jdice/DROP/Defense Thesis/img/v3_boardLayout.png

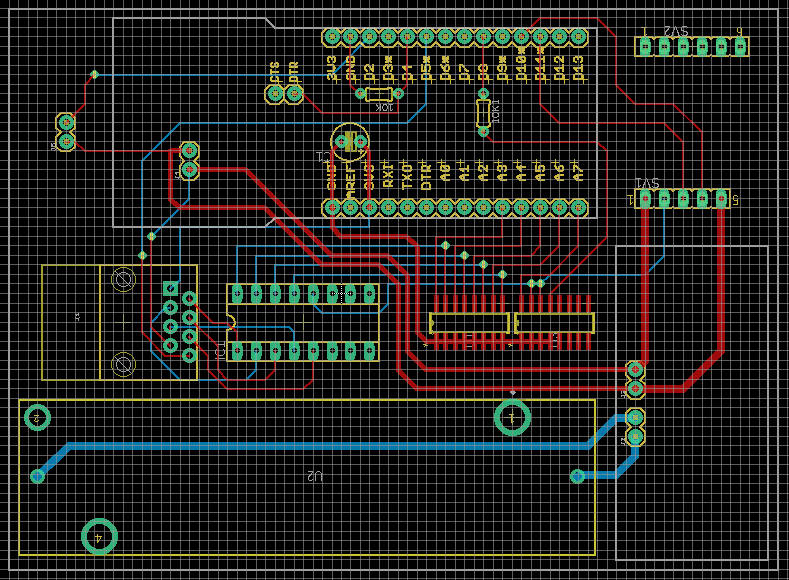
Defense Thesis/img/v3_boardLayout.png
