jdice/DROP/Defense Thesis/img/v3_boards.JPG

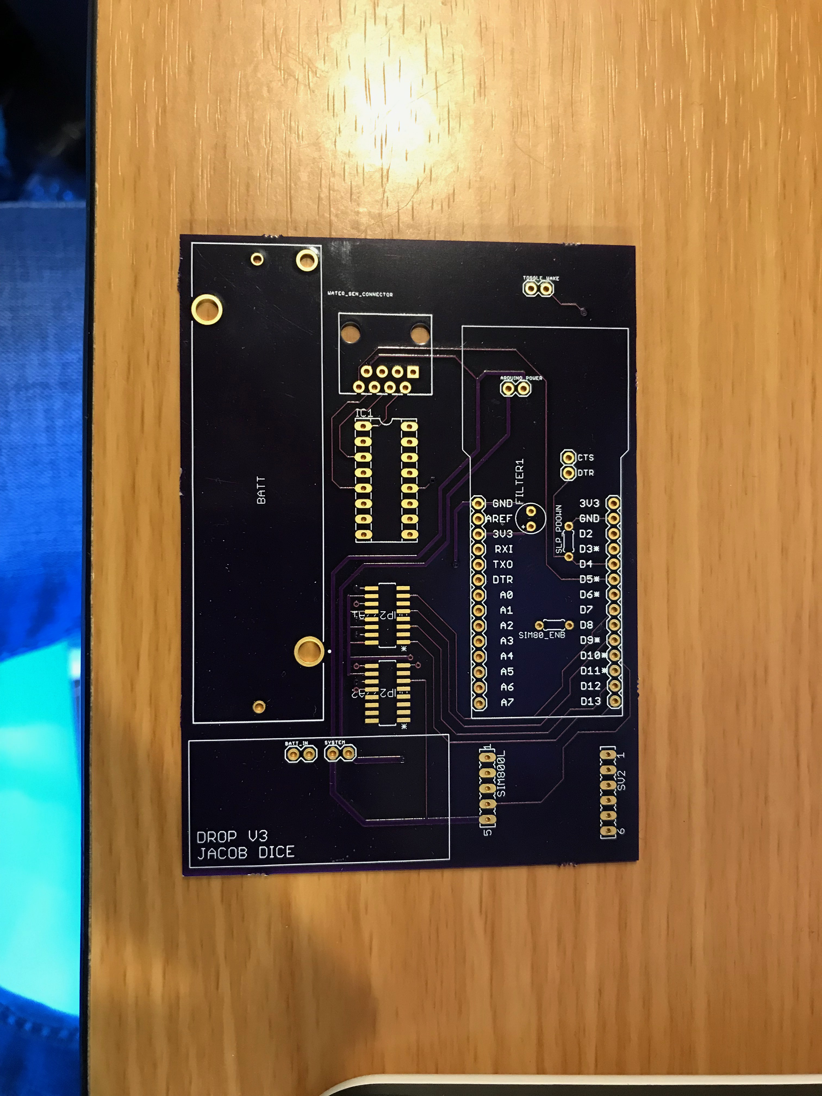
Defense Thesis/img/v3_boards.JPG
