jdice/DROP/Defense Thesis/img/v3_powerConsumption1.JPG

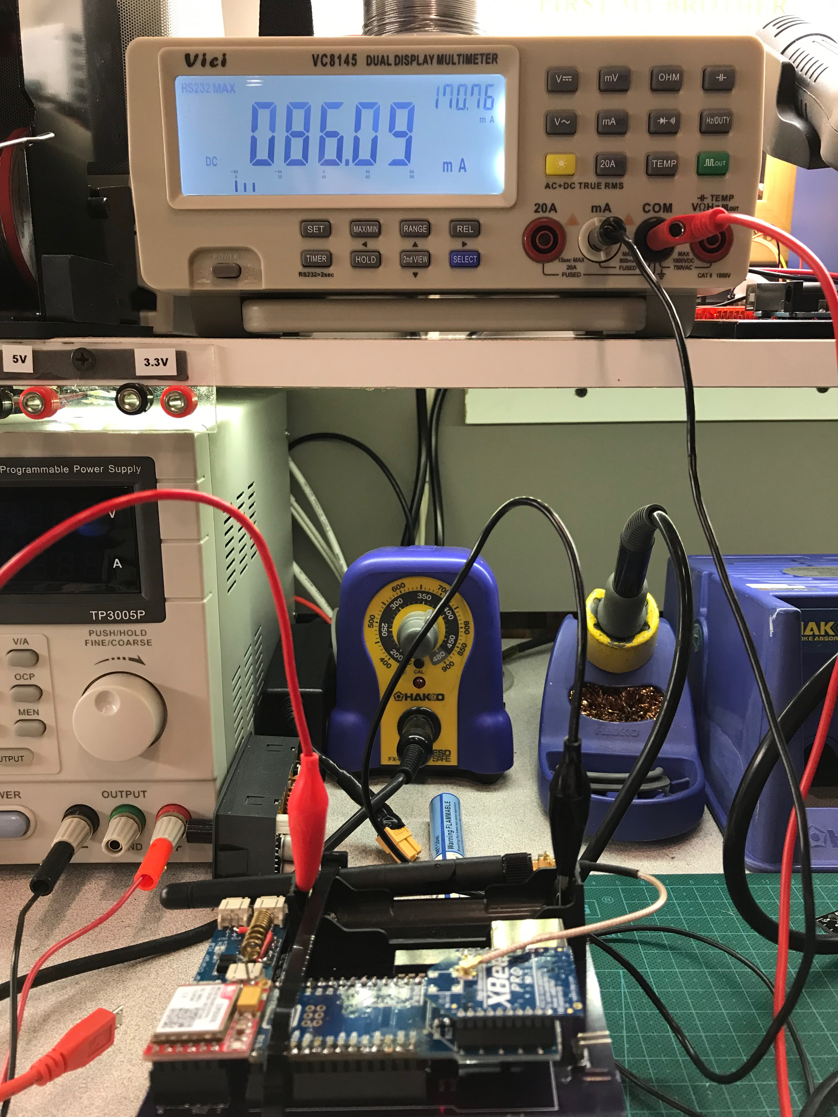
Defense Thesis/img/v3_powerConsumption1.JPG
