jdice/DROP/Defense Thesis/img/v3_powerConsumption2.JPG

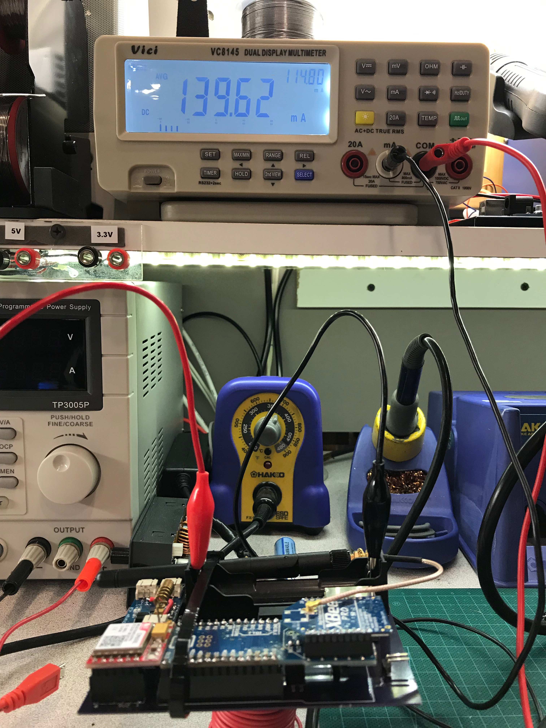
Defense Thesis/img/v3_powerConsumption2.JPG
