jdice/DROP/Defense Thesis/img/v3_powerConsumption3.JPG

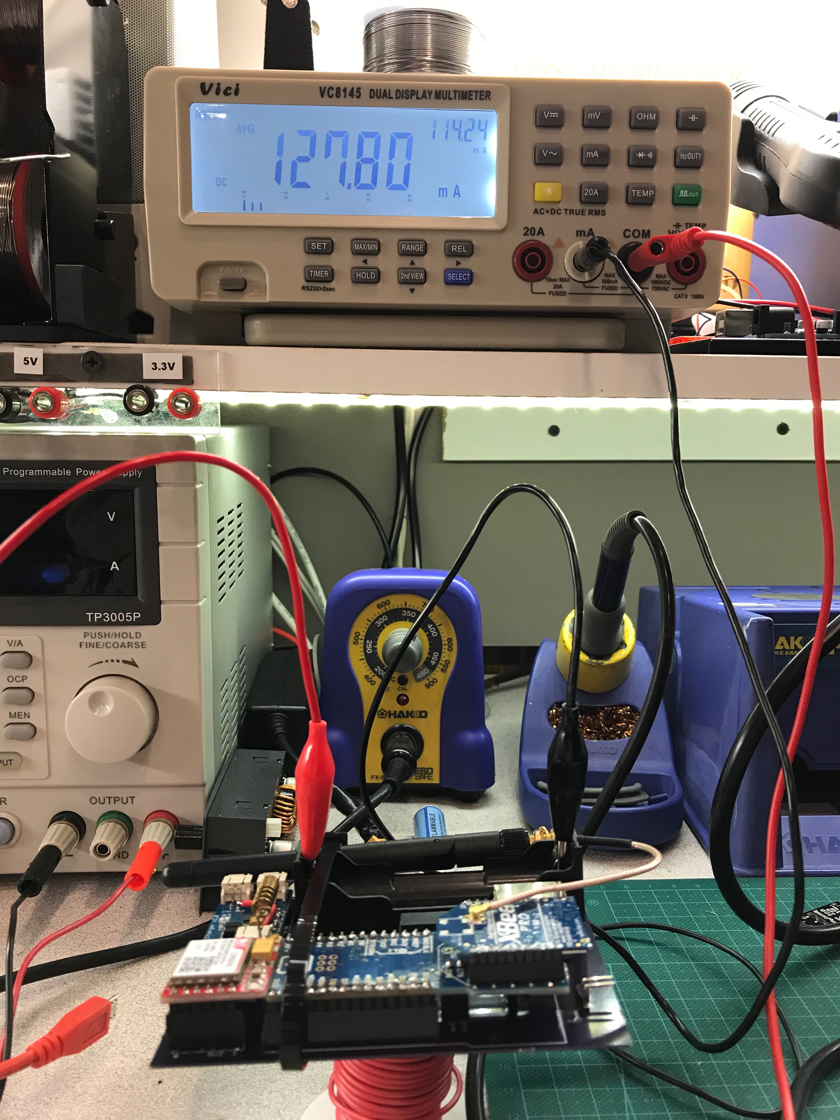
Defense Thesis/img/v3_powerConsumption3.JPG
