jdice/DROP/Defense Thesis/img/v3_schematic.png

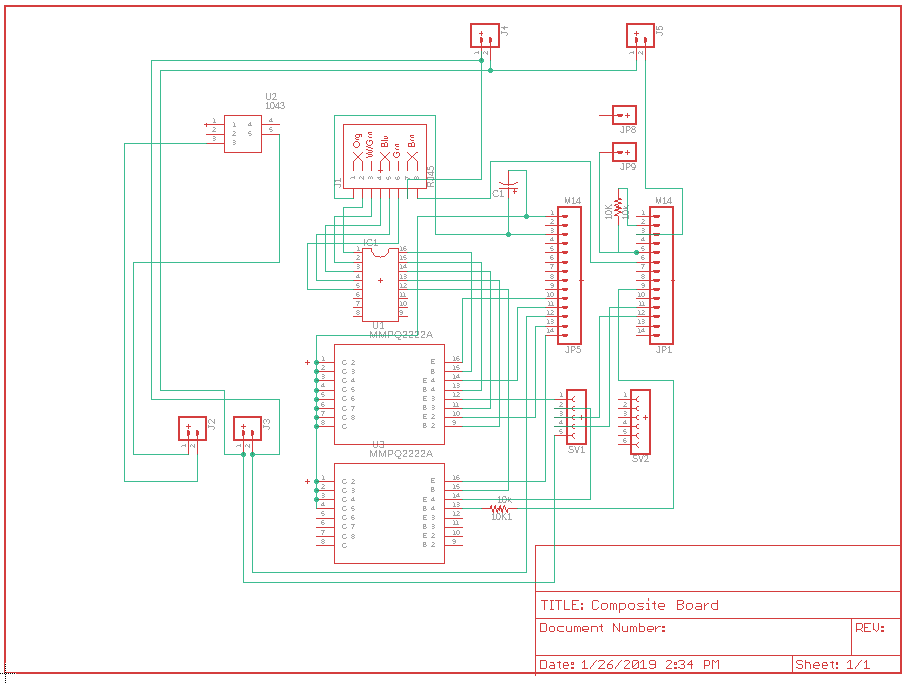
Defense Thesis/img/v3_schematic.png
