jdice/DROP/CAD Drawings/MainHousing.stl

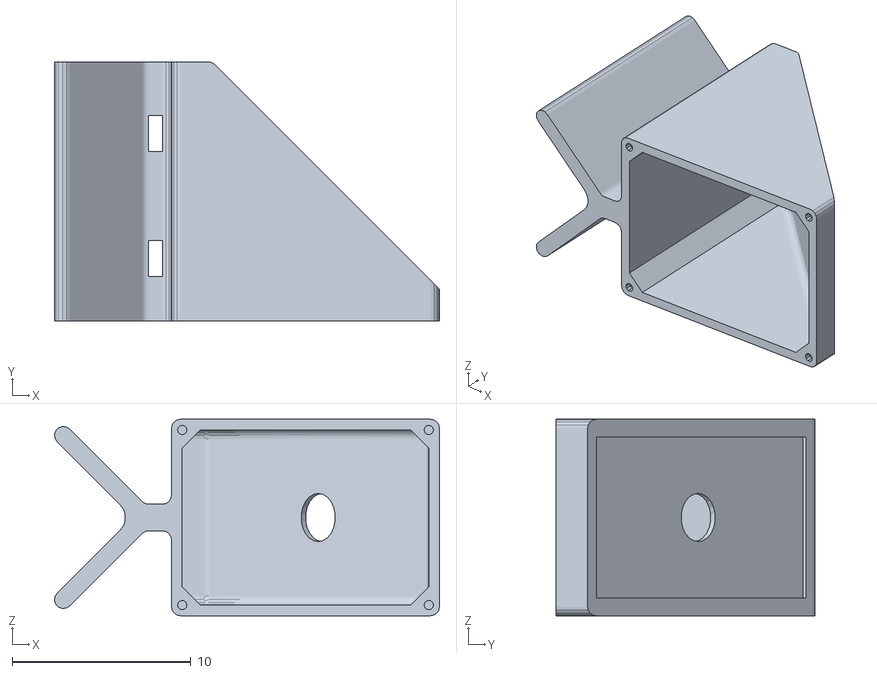
[picture p19: CAD file, 2019-02-03]
CAD Drawings/MainHousing.stl
21.6 x 14.5 x 11.0
