jdice/DROP/CAD Drawings/MainHousing_BottomPlate.stl

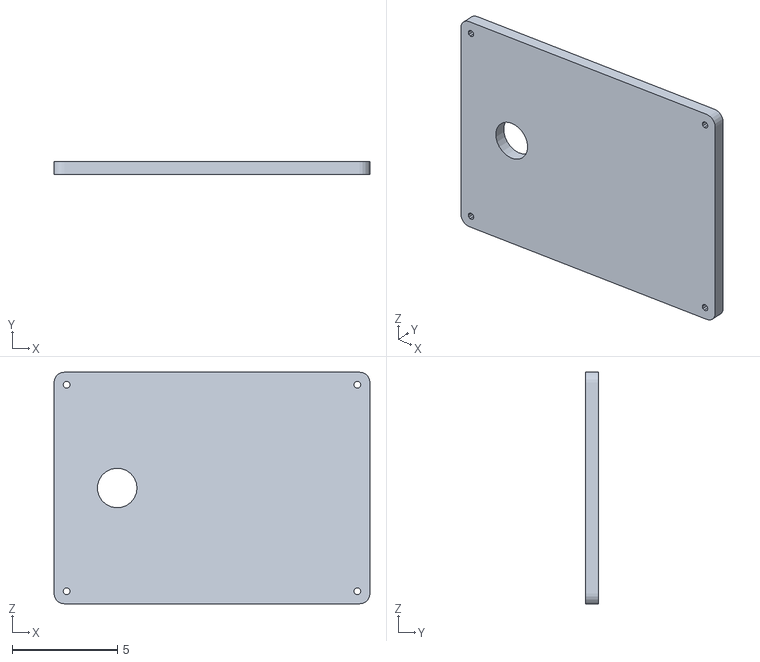
[picture p20: CAD file, 2019-02-03]
CAD Drawings/MainHousing_BottomPlate.stl
15.0 x 0.6 x 11.0
