jdice/DROP/CAD Drawings/PVC_WireAnchor.obj

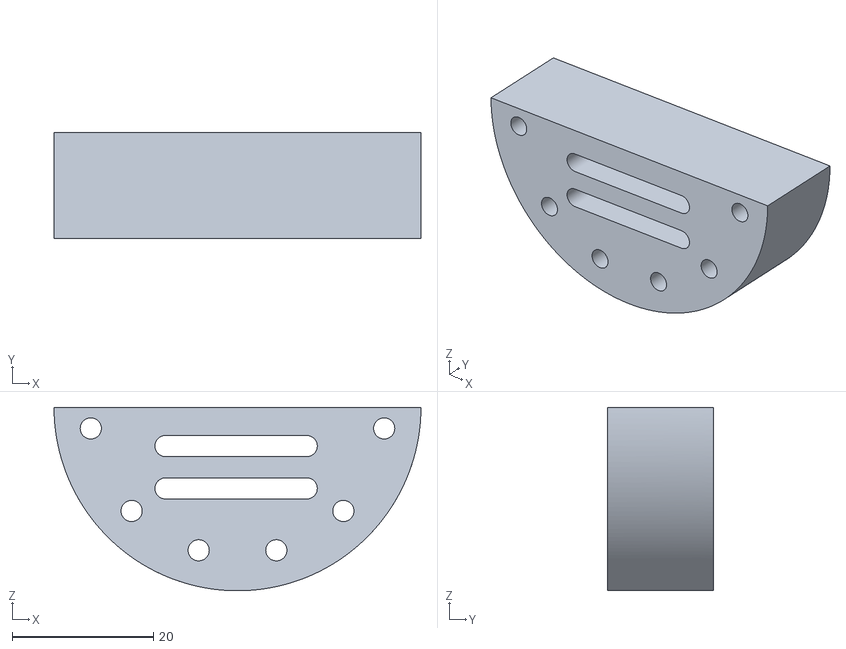
[picture p21: CAD file, 2019-02-03]
CAD Drawings/PVC_WireAnchor.obj
52.0 x 15.0 x 26.0
