jdice/DROP/CAD Drawings/PVC_WireAnchor_Shorter.obj

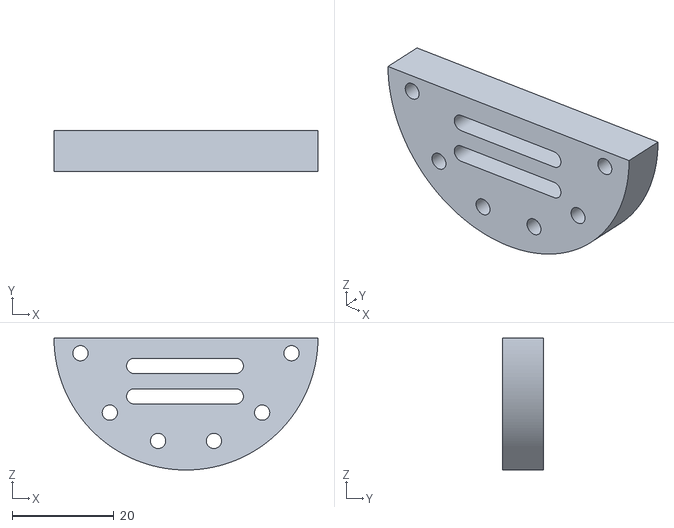
[picture p22: CAD file, 2019-02-03]
CAD Drawings/PVC_WireAnchor_Shorter.obj
52.0 x 8.00 x 26.0
