jdice/DROP/(list of files, cad)

Other CAD files:
CAD Drawings/MainHousing.ipt
CAD Drawings/MainHousing_BottomPlate.ipt
CAD Drawings/PVC_WireAnchor.ipt
CAD Drawings/SensorAssembly.iam
CAD Drawings/SensorAssembly.ipn
CAD Drawings/SolarPanel.ipt
CAD Drawings/StreetLight.ipt
CAD Drawings/StreetLight_r2.ipt
CAD Drawings/Streetlight_Sensor.iam
