jdice/DROP/Defense Thesis/img/v3_assembled.JPG

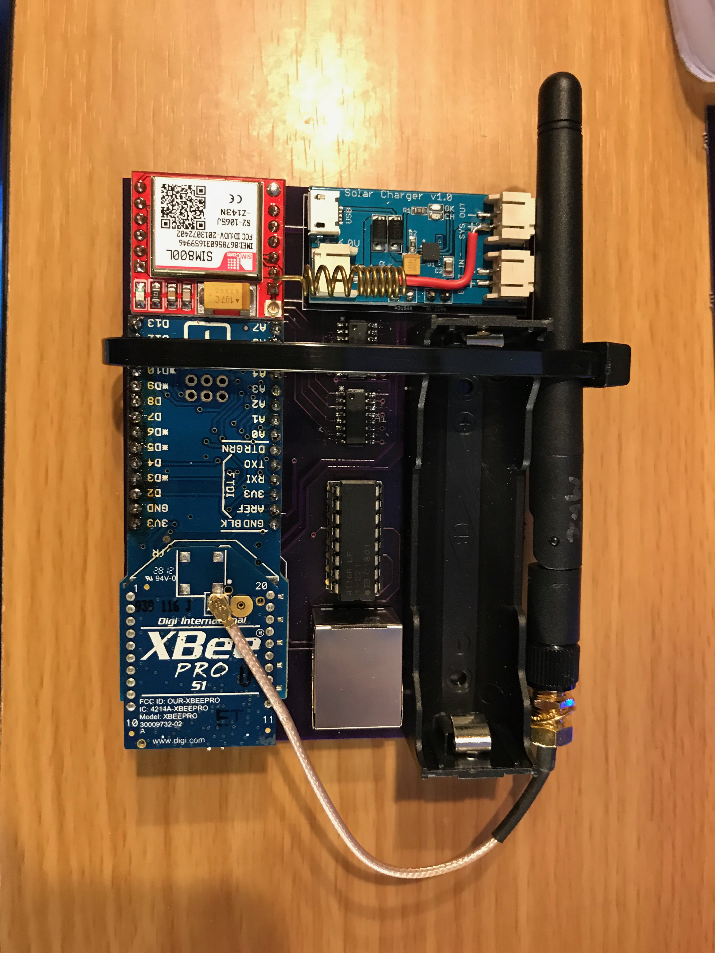
Defense Thesis/img/v3_assembled.JPG
