jdice/DROP/Defense Thesis/img/CompositeBoard.pdf

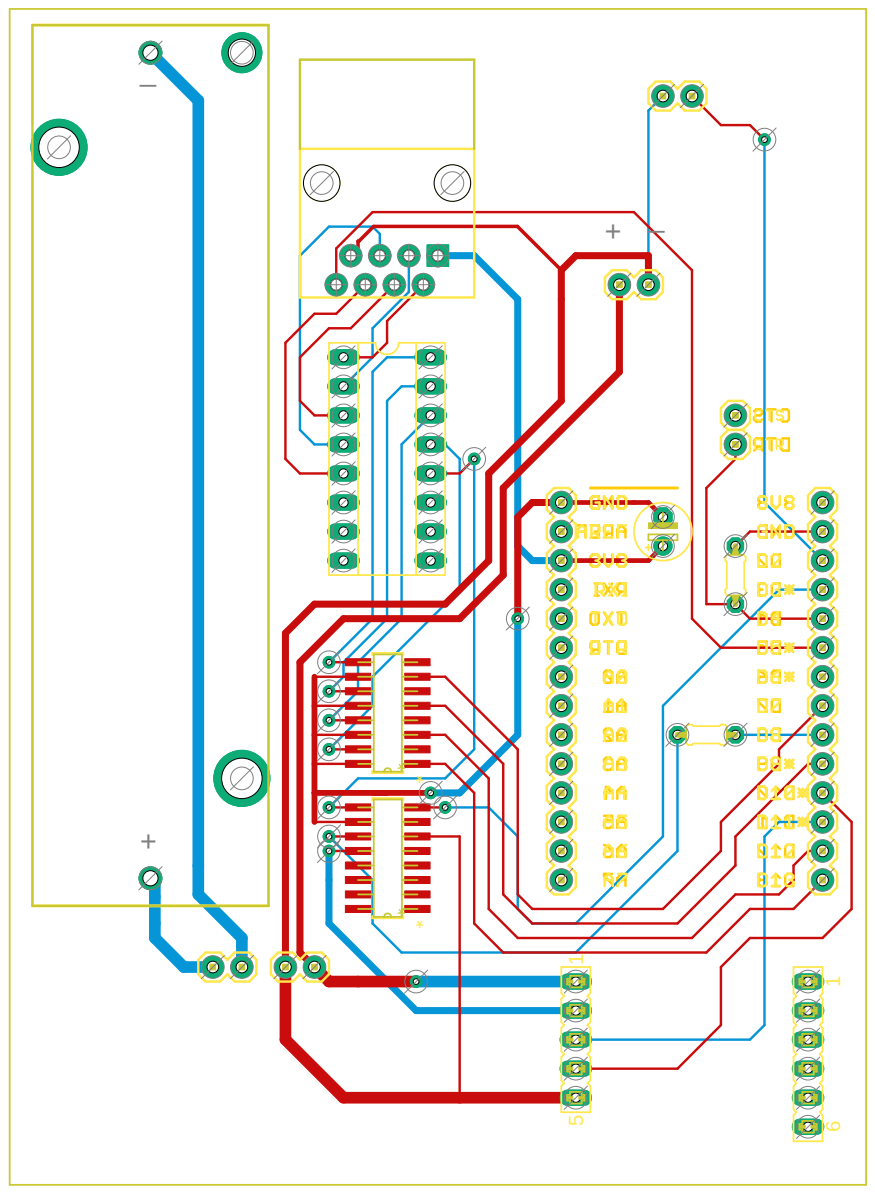
[picture p24: page 1]
