jdice/DROP/Defense Thesis/img/CompositeSchematic.pdf

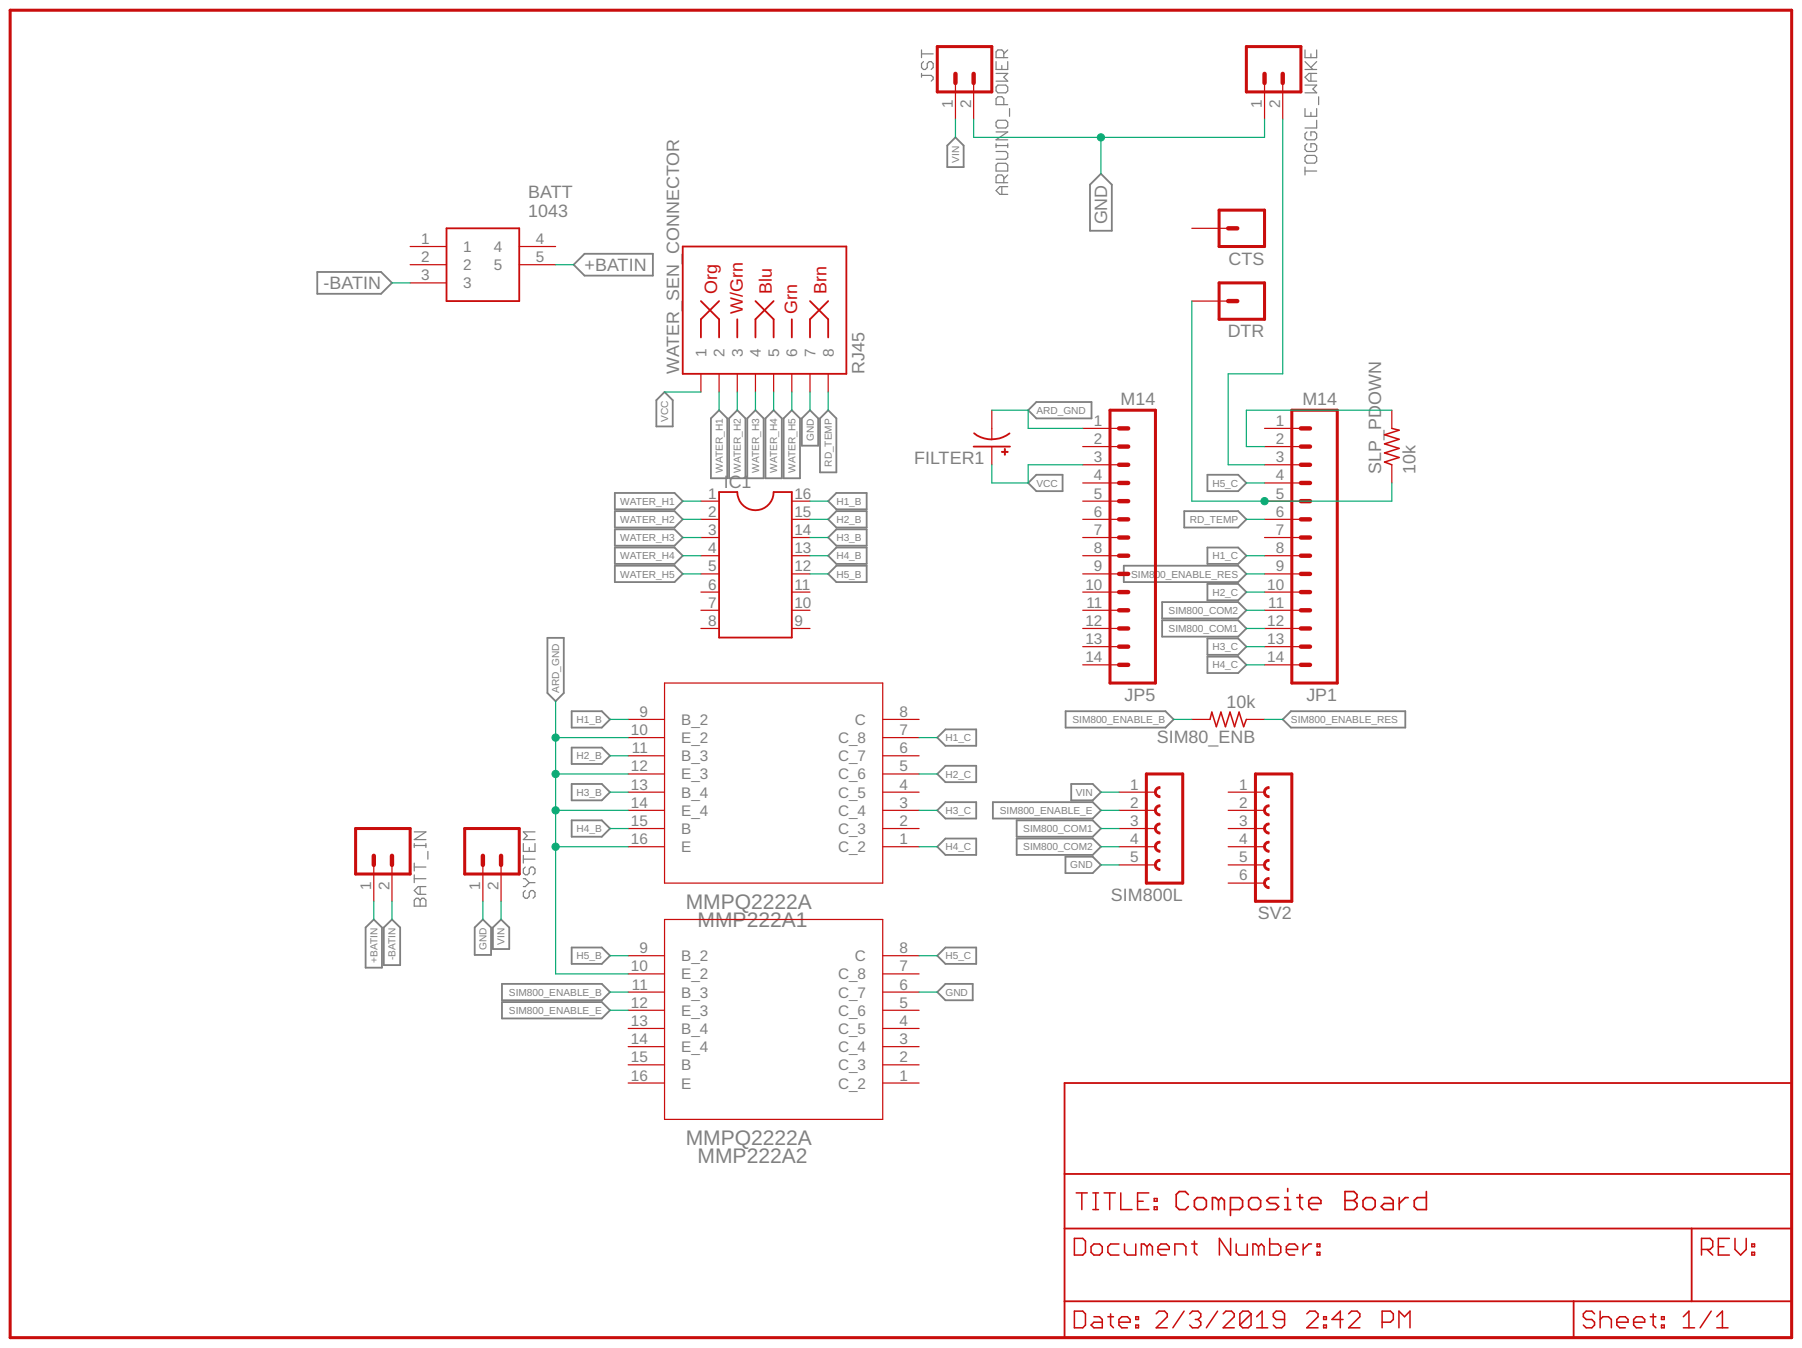
[picture p25: page 1]

ARD_GND Org Blu Brn W/Grn Grn
