jdice/DROP/PCB Design Files/DROP_WaterSensor/WaterProbe_TopConnector.brd

## EAGLE design PCB Design Files/DROP_WaterSensor/WaterProbe_TopConnector.brd (2019-02-03)

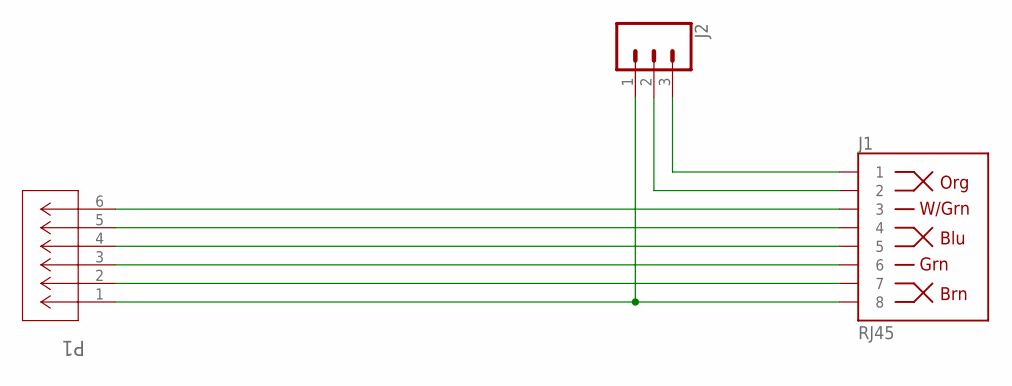
[picture p26: schematic WaterProbe_TopConnector.sch]

Parts:
J1: RJ45; RJ45-8
J2: CONN_03; 1X03
P1: 6PINJSTS6B-ZR(LF)(SN); S6B-ZR

Connections:
unnamed: J1.8, J2.1, P1.1
unnamed: J1.7, P1.2
unnamed: J1.6, P1.3
unnamed: J1.5, P1.4
unnamed: J1.4, P1.5
unnamed: J1.3, P1.6
unnamed: J1.1, J2.3
unnamed: J1.2, J2.2

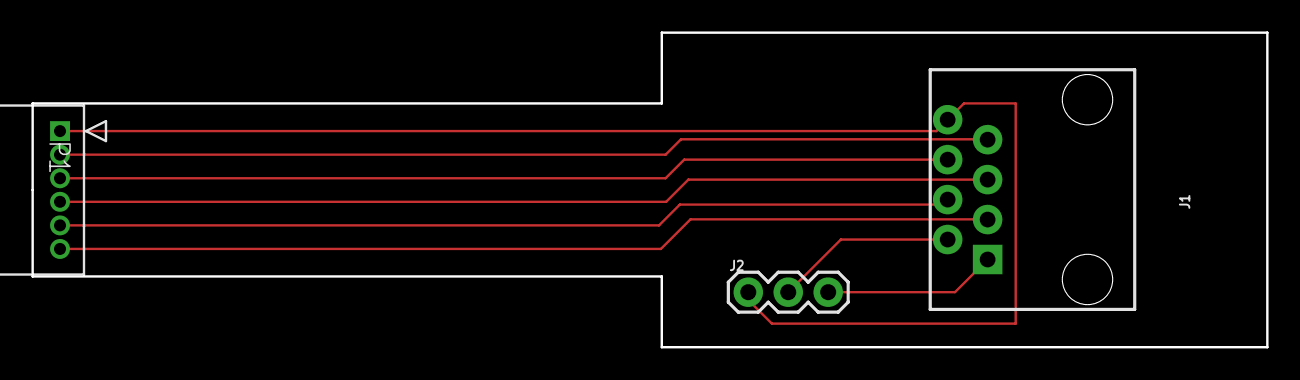
[picture p27: board WaterProbe_TopConnector.brd from above]

Board: 2 copper layers, 78.5 x 20.0 mm, 3 parts (0 on the bottom side), 8 nets.
