jdice/DROP/PCB Design Files/DROP_CompositeBoard/Composite Board.brd

## EAGLE design PCB Design Files/DROP_CompositeBoard/Composite Board.brd (2019-02-03)

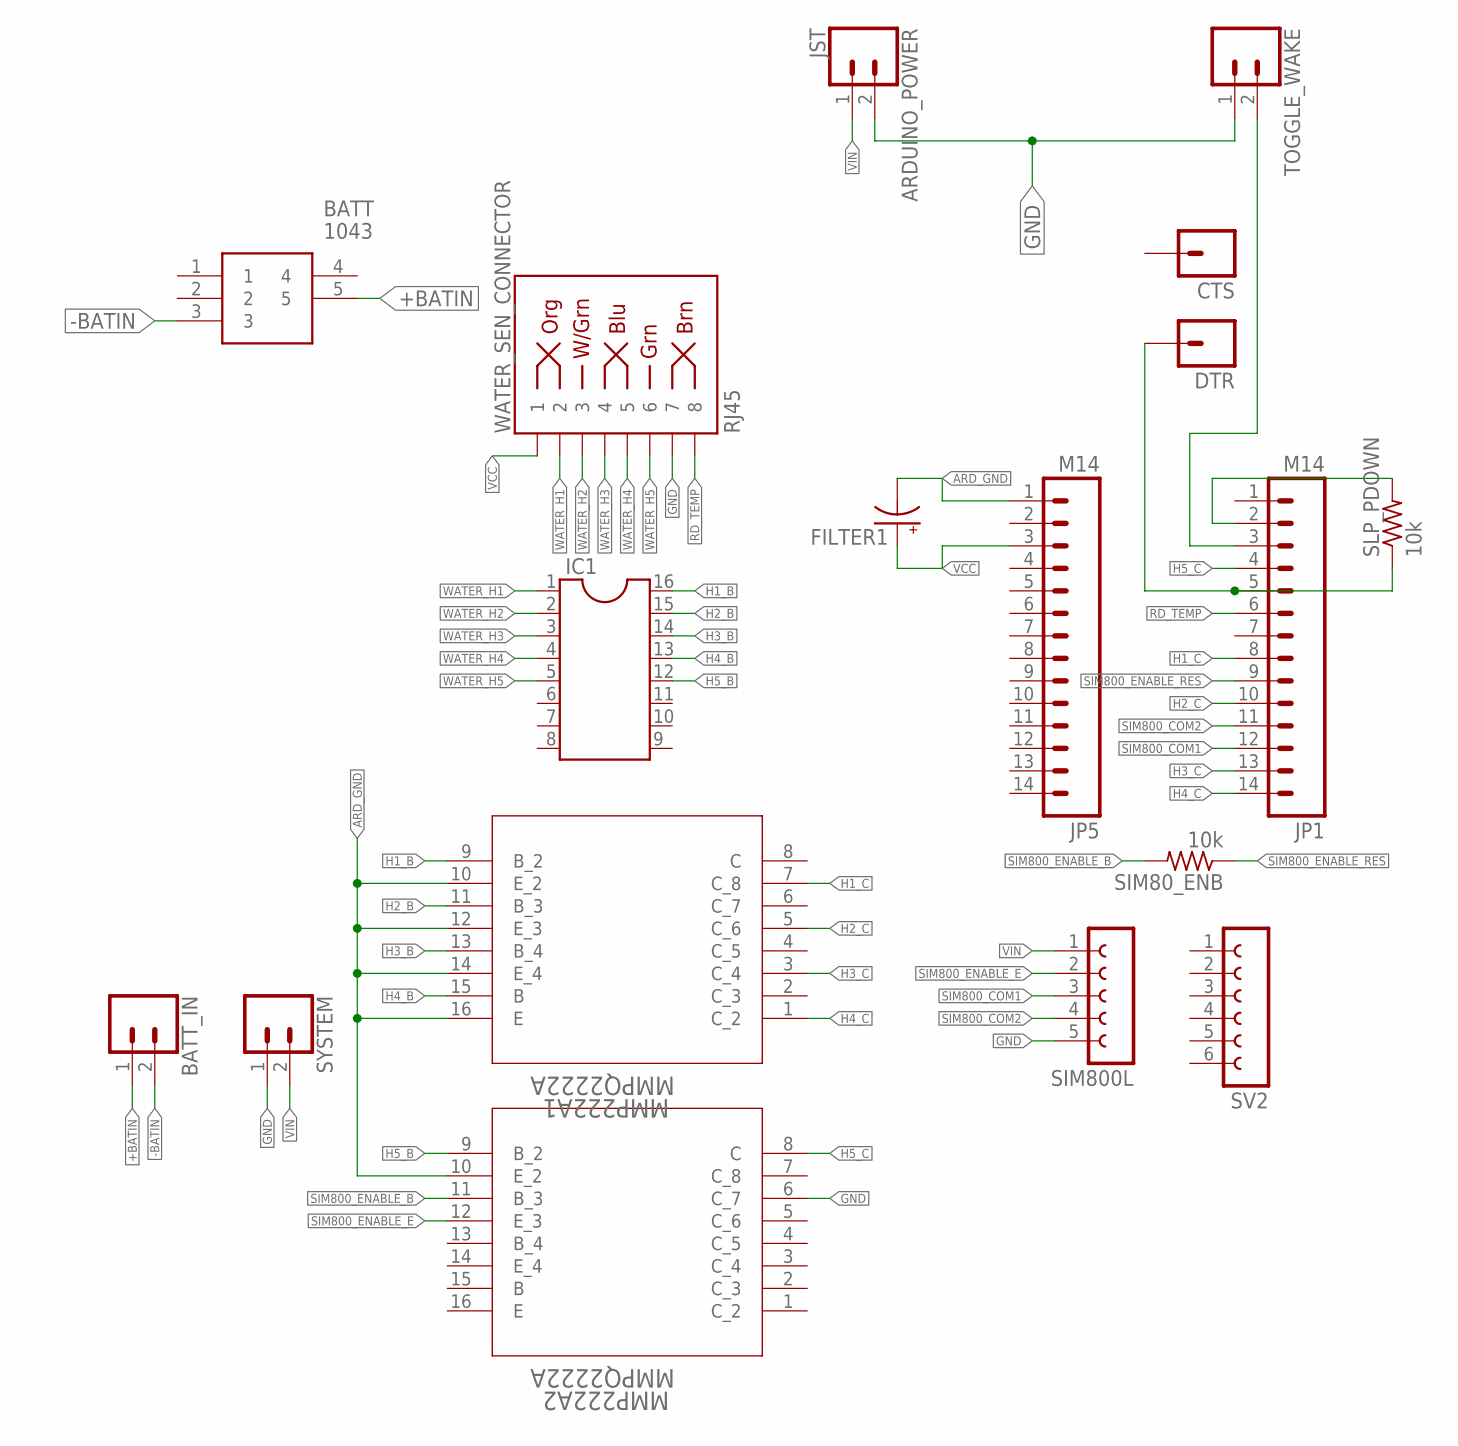
[picture p28: schematic Composite Board.sch]

Parts:
ARDUINO_POWER: JST; 1X02
BATT: 1043
BATT_IN: CONN_02; 1X02
CTS: M01PTH; 1X01
DTR: M01PTH; 1X01
FILTER1: CPOL-USE2.5-5; E2,5-5
IC1: DIL16S; SOCKET-16
JP1, JP5: M14; 1X14
MMP222A1, MMP222A2: MMPQ2222A; SO-G16
SIM80_ENB: 10k; 0204/5
SIM800L: FE05-1
SLP_PDOWN: 10k; 0204/5
SV2: FE06-1; FE06
SYSTEM: CONN_02; 1X02
TOGGLE_WAKE: CONN_02; 1X02
WATER_SEN_CONNECTOR: RJ45; RJ45-8

Connections:
+BATIN: BATT.5, BATT_IN.1
-BATIN: BATT.3, BATT_IN.2
ARD_GND: FILTER1.-, JP5.1, MMP222A1.10 (E_2), MMP222A1.12 (E_3), MMP222A1.14 (E_4), MMP222A1.16 (E), MMP222A2.10 (E_2)
GND: ARDUINO_POWER.2, MMP222A2.6 (C_7), SIM800L.5, SYSTEM.1, TOGGLE_WAKE.1, WATER_SEN_CONNECTOR.7
H1_B: IC1.16, MMP222A1.9 (B_2)
H1_C: JP1.8, MMP222A1.7 (C_8)
H2_B: IC1.15, MMP222A1.11 (B_3)
H2_C: JP1.10, MMP222A1.5 (C_6)
H3_B: IC1.14, MMP222A1.13 (B_4)
H3_C: JP1.13, MMP222A1.3 (C_4)
H4_B: IC1.13, MMP222A1.15 (B)
H4_C: JP1.14, MMP222A1.1 (C_2)
H5_B: IC1.12, MMP222A2.9 (B_2)
H5_C: JP1.4, MMP222A2.8 (C)
unnamed: DTR.1, JP1.5, SLP_PDOWN.1
unnamed: JP1.2, SLP_PDOWN.2
unnamed: JP1.3, TOGGLE_WAKE.2
RD_TEMP: JP1.6, WATER_SEN_CONNECTOR.8
SIM800_COM1: JP1.12, SIM800L.3
SIM800_COM2: JP1.11, SIM800L.4
SIM800_ENABLE_B: MMP222A2.11 (B_3), SIM80_ENB.2
SIM800_ENABLE_E: MMP222A2.12 (E_3), SIM800L.2
SIM800_ENABLE_RES: JP1.9, SIM80_ENB.1
VCC: FILTER1.+, JP5.3, WATER_SEN_CONNECTOR.1
VIN: ARDUINO_POWER.1, SIM800L.1, SYSTEM.2
WATER_H1: IC1.1, WATER_SEN_CONNECTOR.2
WATER_H2: IC1.2, WATER_SEN_CONNECTOR.3
WATER_H3: IC1.3, WATER_SEN_CONNECTOR.4
WATER_H4: IC1.4, WATER_SEN_CONNECTOR.5
WATER_H5: IC1.5, WATER_SEN_CONNECTOR.6

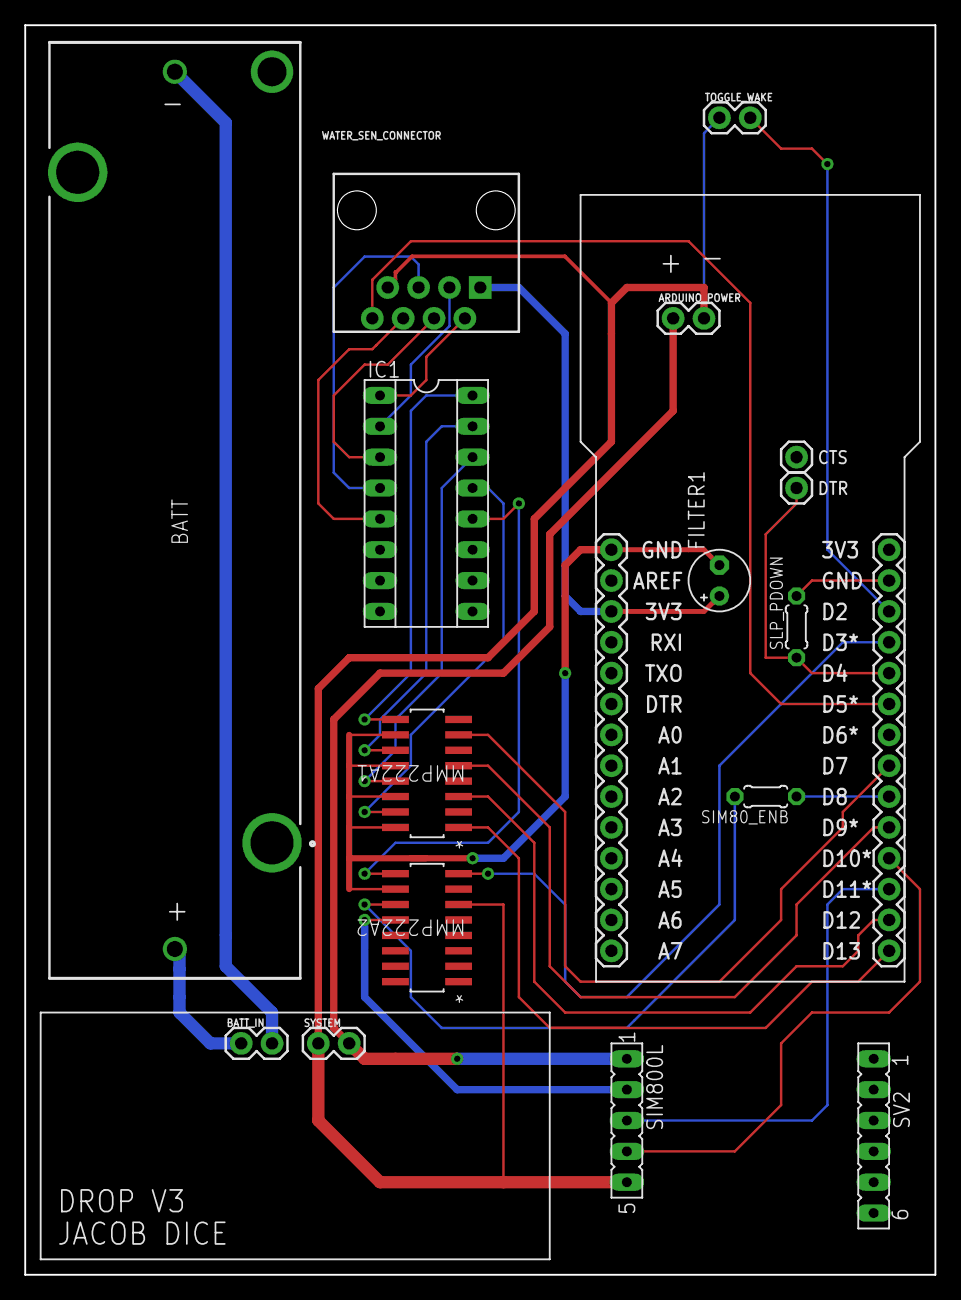
[picture p29: board Composite Board.brd from above]

Board: 2 copper layers, 74.9 x 102.9 mm, 18 parts (0 on the bottom side), 30 nets.
